dukelec/cdfoc/hardware/cdfoc_pcb_v4.1.png

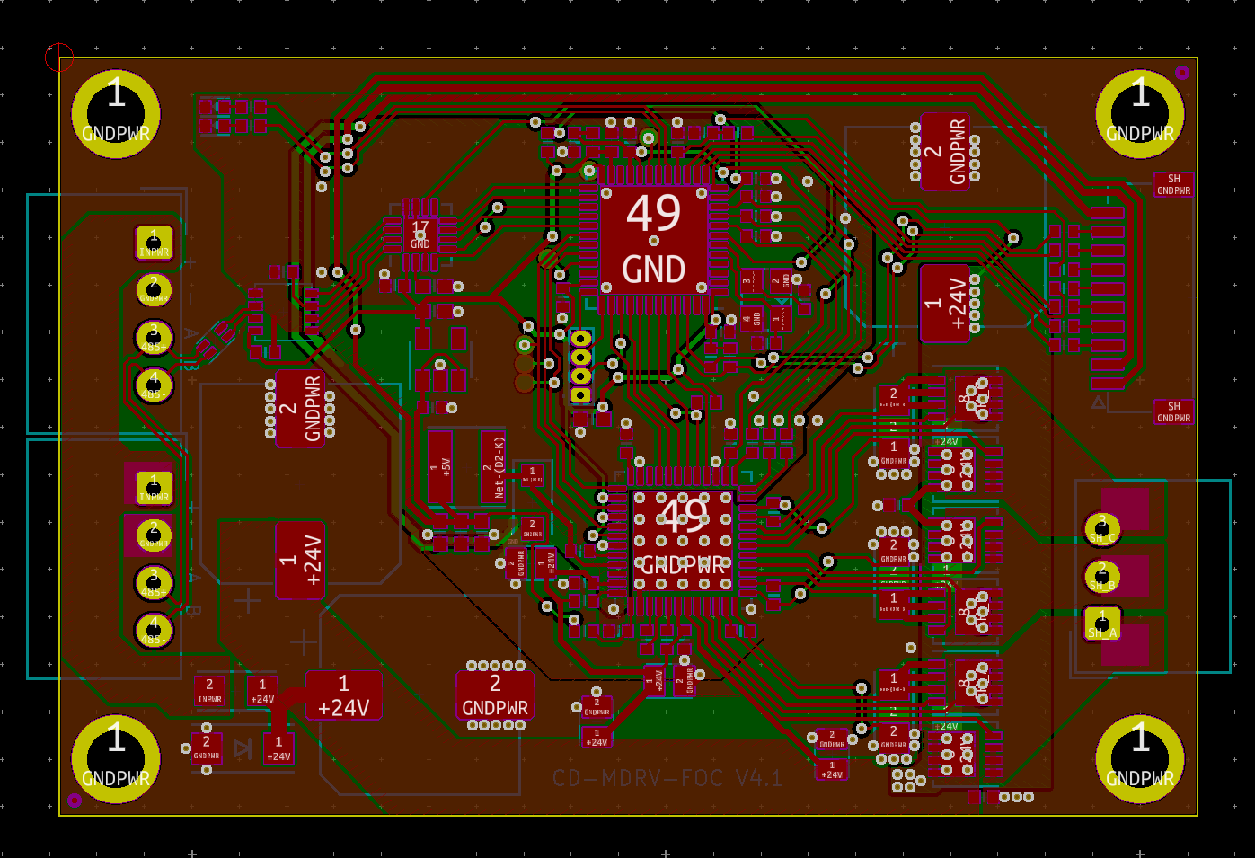
hardware/cdfoc_pcb_v4.1.png
