dukelec/cdfoc/hardware/sensor_tle5014_v1.png

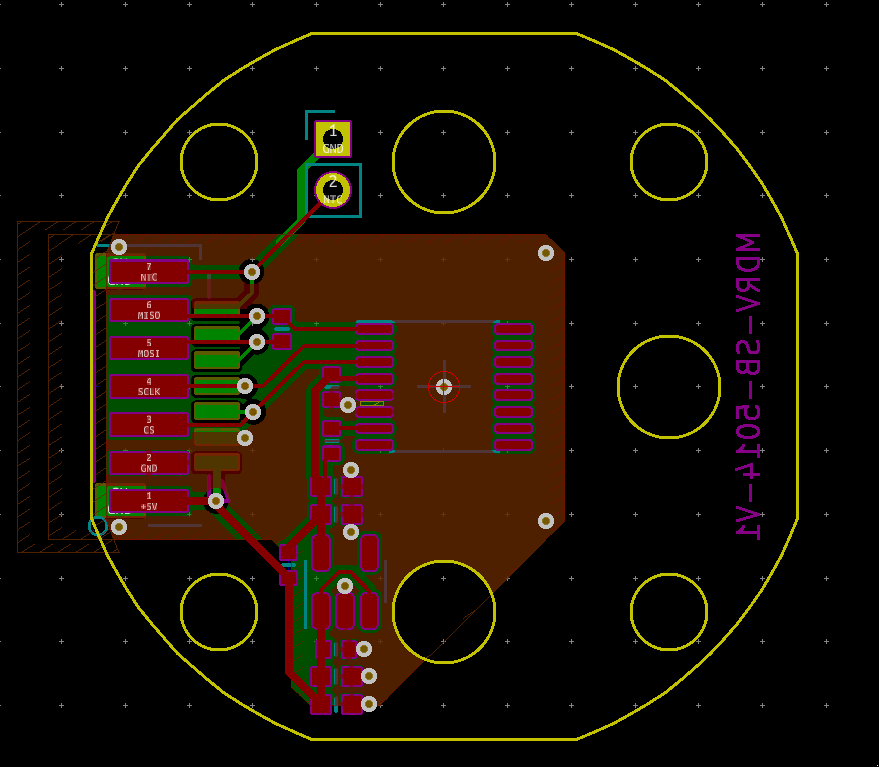
hardware/sensor_tle5014_v1.png
