dukelec/cdfoc/hardware/cdfoc_driver_v4.4_todo.pdf

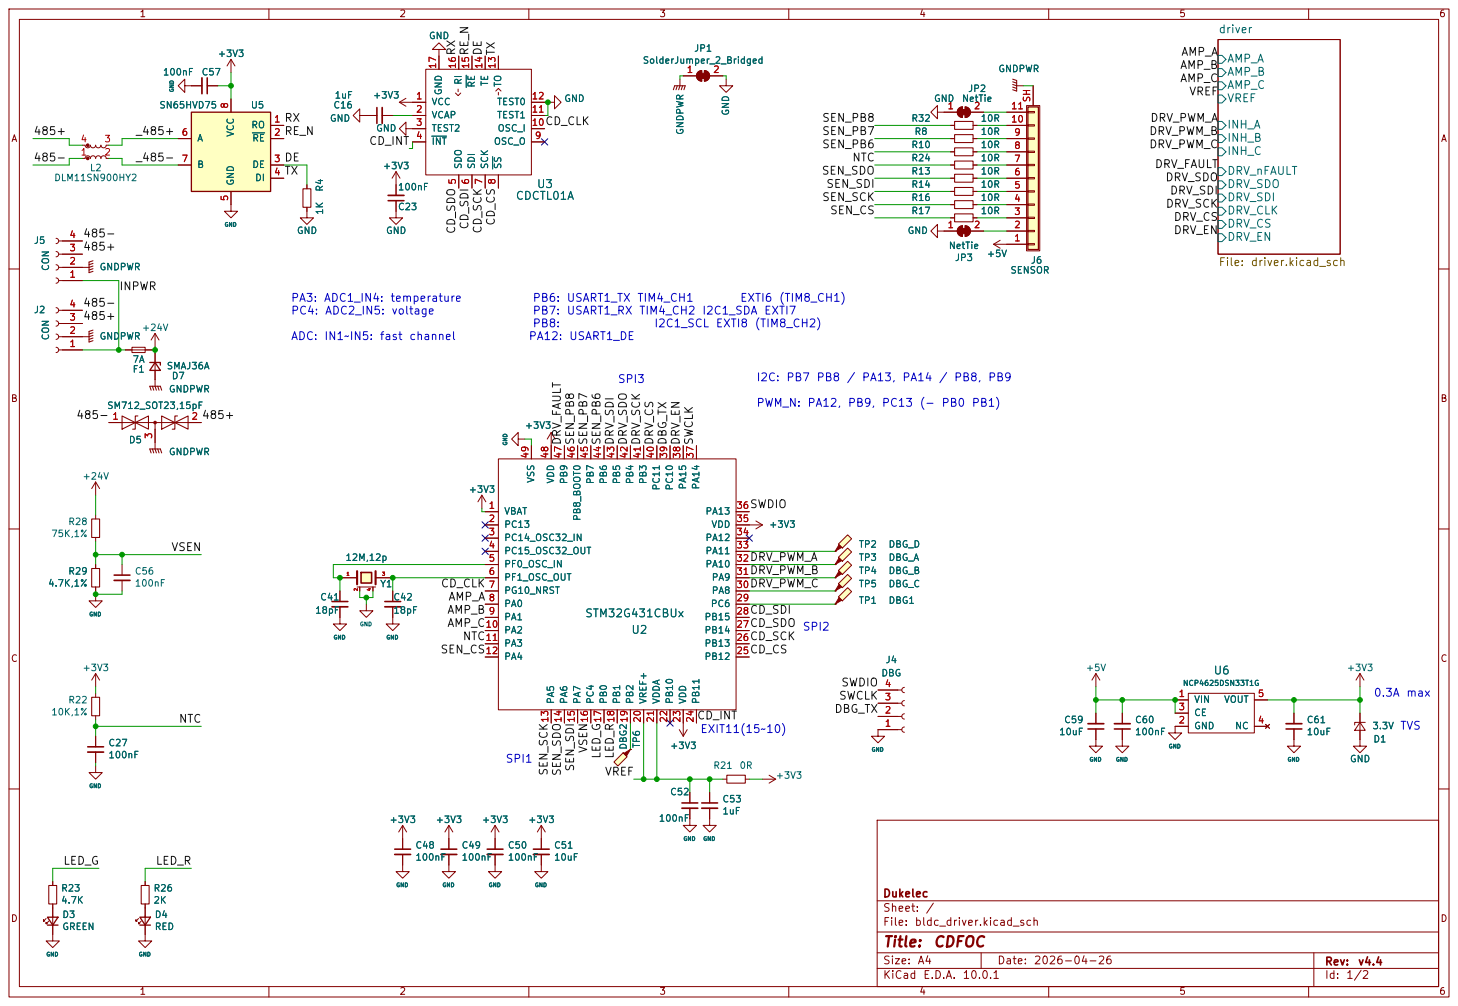
[picture p3: page 1]

8 OSC_O 9 OSC_I 10 TEST1 11 TEST0 12 TO 13 TE 14 RE 15 RI 16 GND 17 GND

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

Size: A4 | Rev: v4.4
KiCad E.D.A. 10.0.1 | Id: 1/2

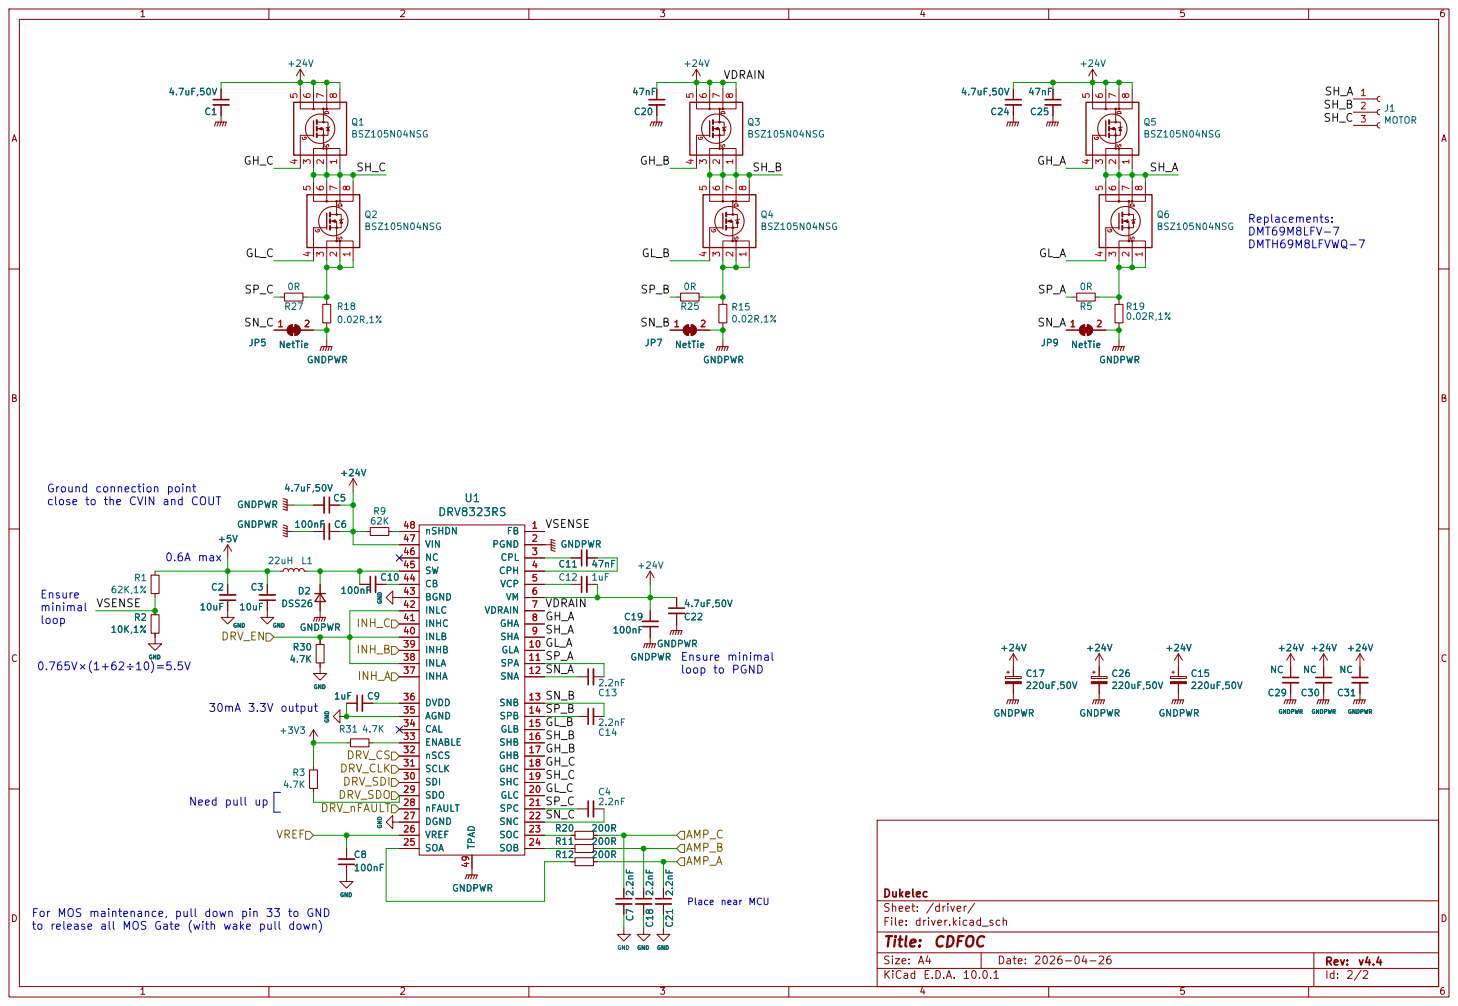
[picture p4: page 2]

Ground connection point
close to the CVIN and COUT

For MOS maintenance, pull down pin 33 to GND
to release all MOS Gate (with wake pull down)

Size: A4 | Rev: v4.4
KiCad E.D.A. 10.0.1 | Id: 2/2
