dukelec/cdfoc/hardware/sensor_tle5012_v1.pdf

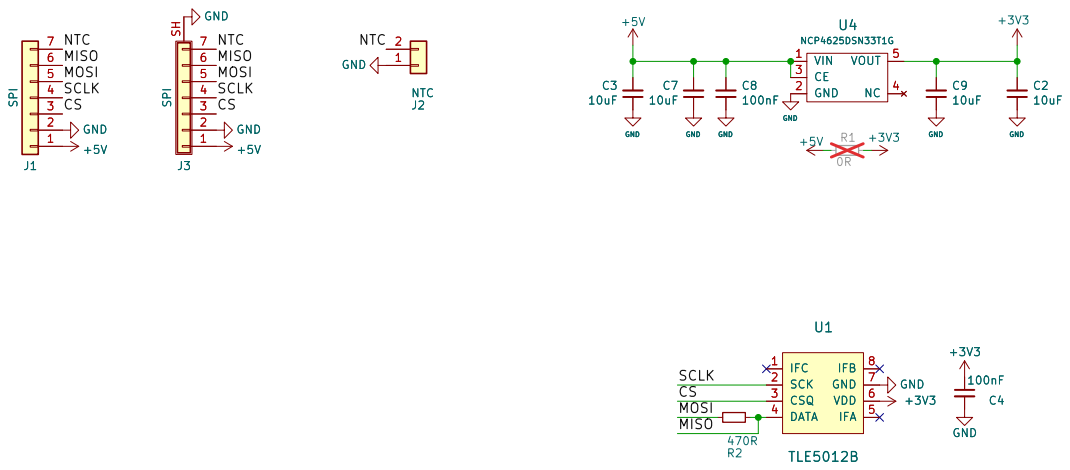
[picture p5: page 1]

Size: A4 | Rev: V1
KiCad E.D.A. 10.0.1 | Id: 1/1
