dukelec/cdfoc/hardware/cdfoc_driver_v4.3.1.pdf

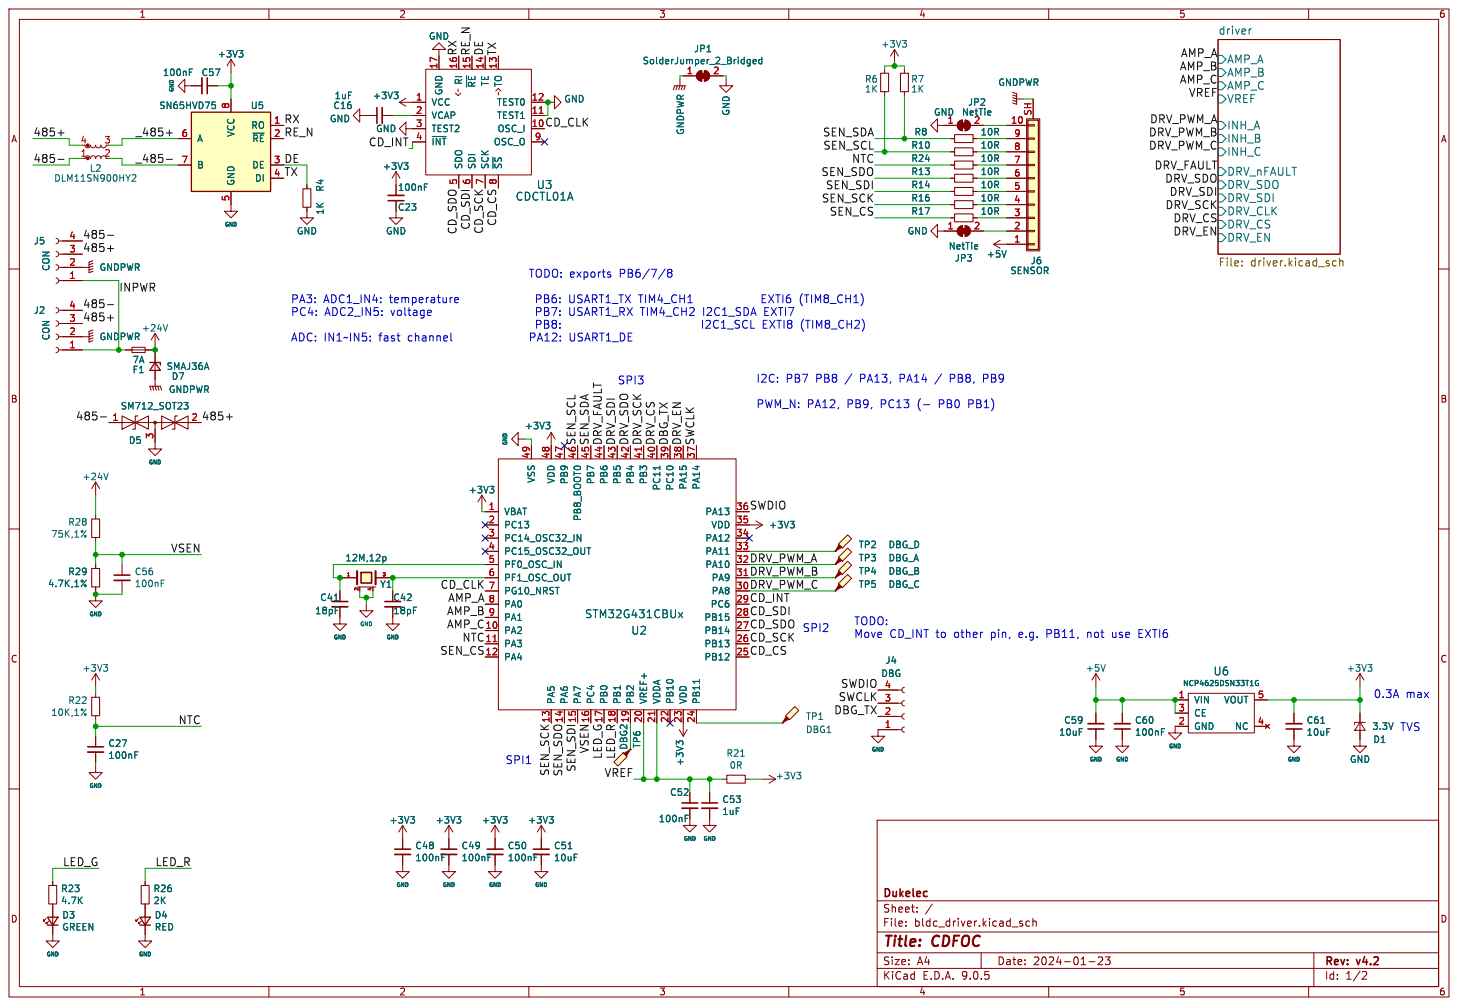
[picture p6: page 1]

driver File: driver.kicad_sch D3 GREEN

5 ~{RE}15 SDI 6 TE 14 SCK

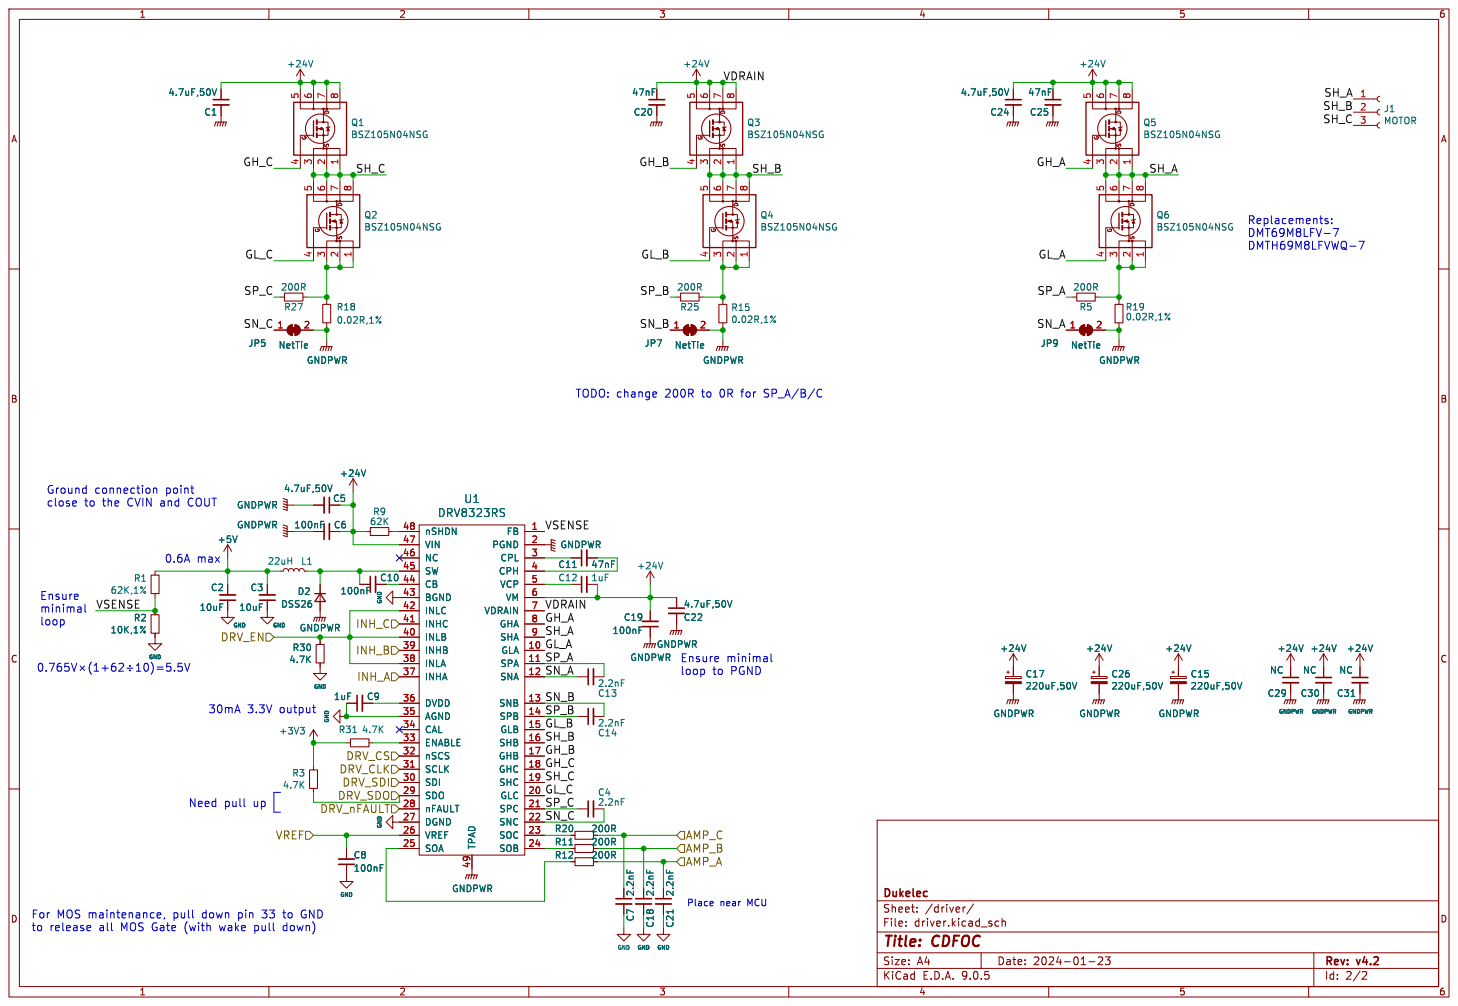
[picture p7: page 2]

TODO: change 200R to 0R for SP_A/B/C
100nF GND GND C8
D2 DSS26 R30

Place near MCU Ensure minimal

to release all MOS Gate (with wake pull down) Need pull up

File: driver.kicad_sch Sheet: /driver/ Dukelec
