dukelec/cdfoc/hardware/sensor_tle5014_v1.pdf

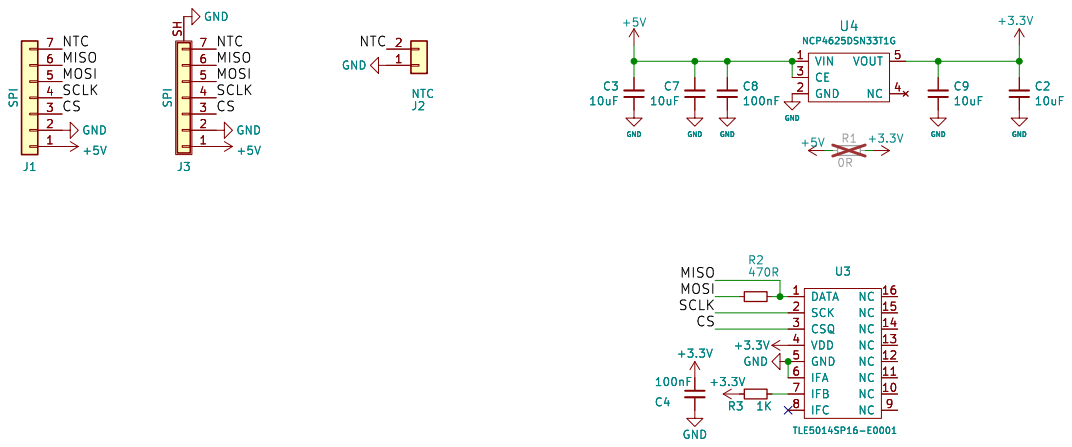
[picture p8: page 1]

Id: 1/1 Title: CDFOC SENSOR TLE5014
