dukelec/cdfoc/hardware/cdfoc_driver_v4.2.pdf

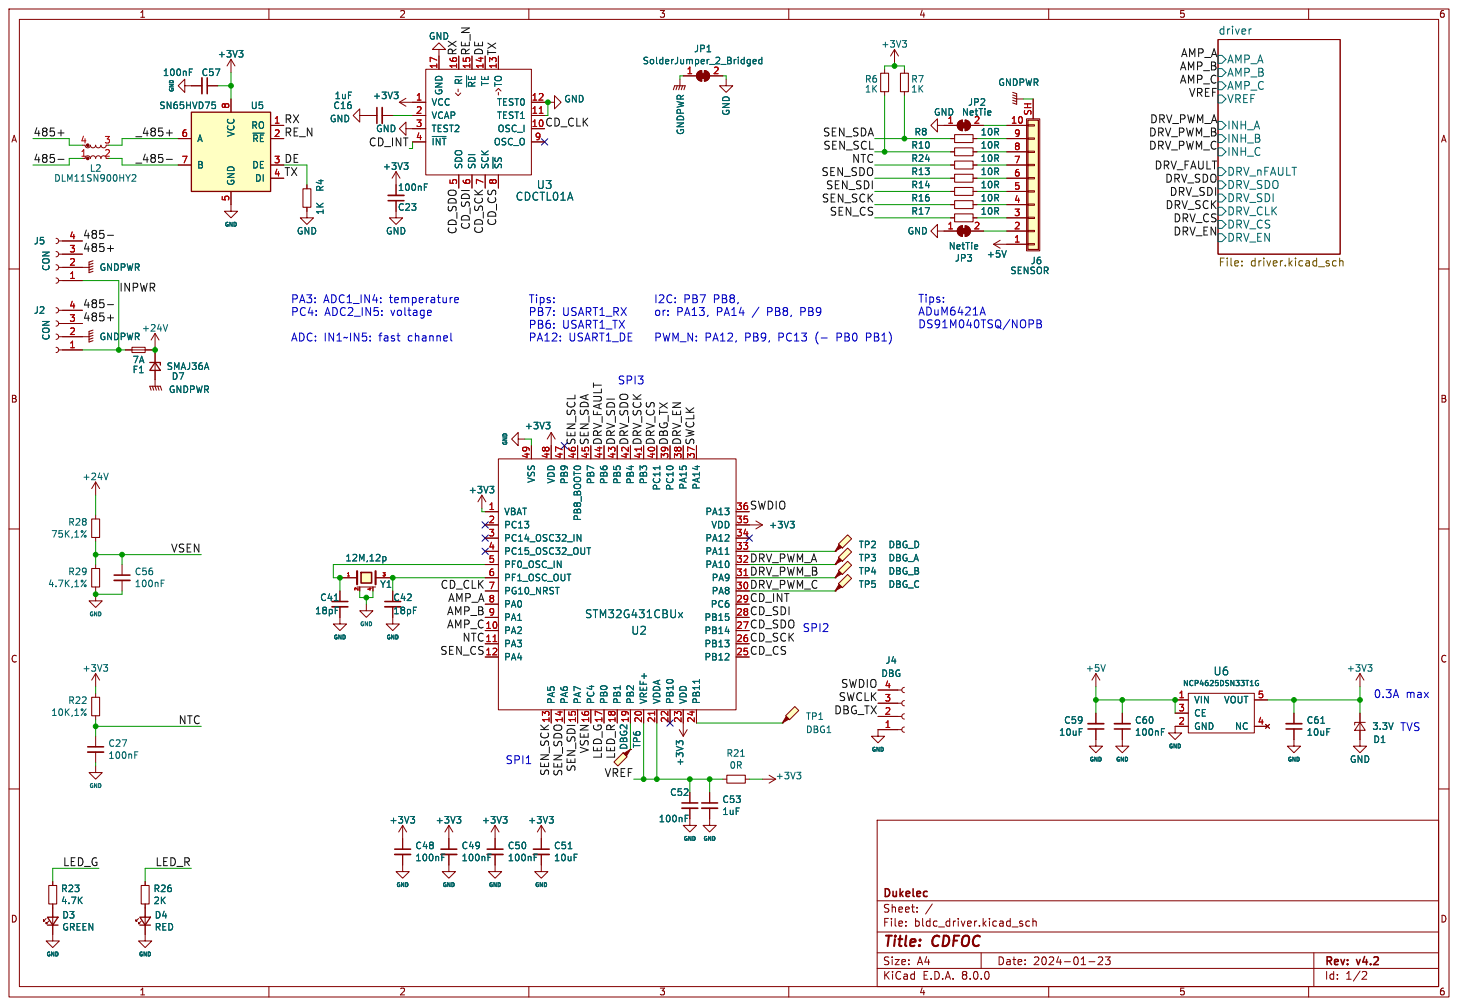
[picture p9: page 1]

7 ~{SS} 8 OSC_O 9 GND GND GND

RO 1 ~{RE}2 DE 3 DI 4 GND

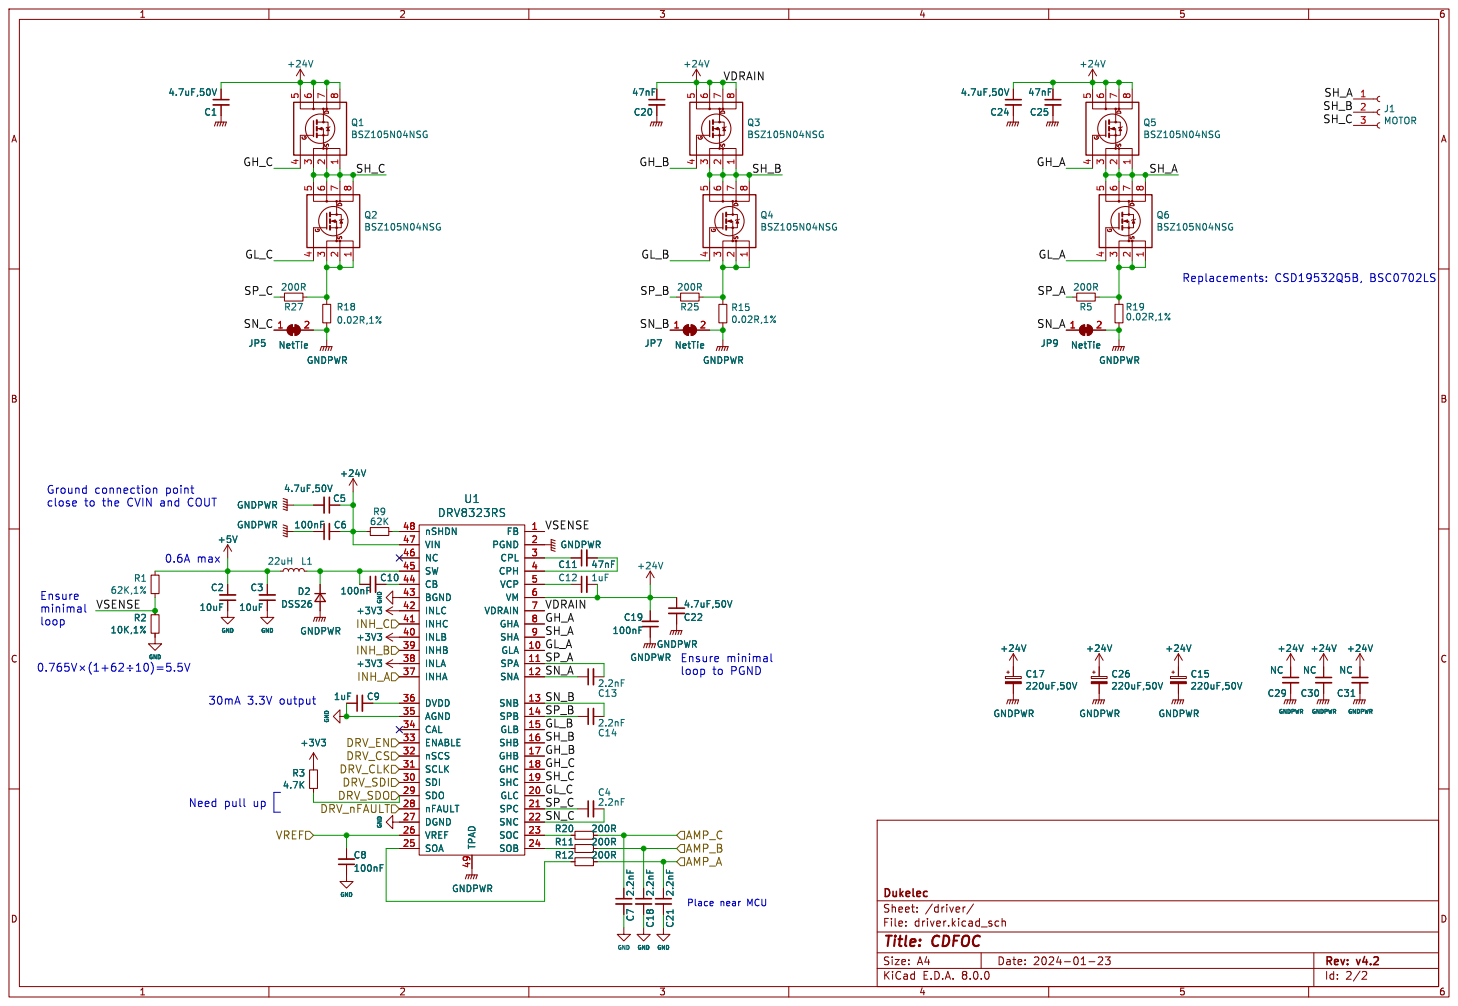
[picture p10: page 2]

File: driver.kicad_sch Sheet: /driver/ Dukelec
