dukelec/cdfoc/hardware/cdfoc_driver_v4.1.pdf

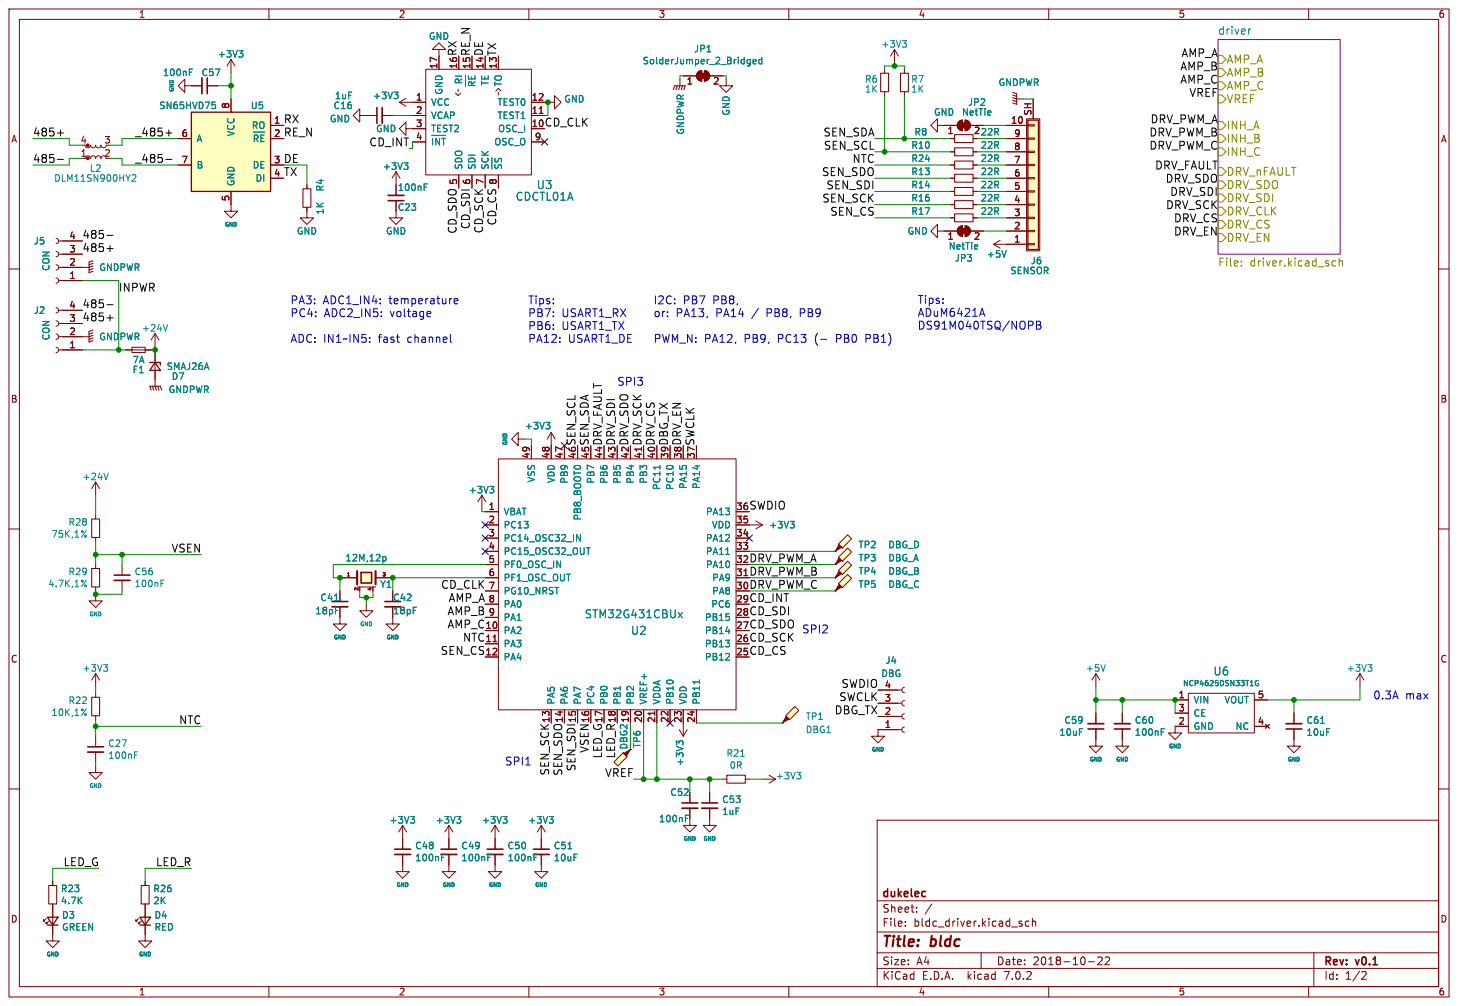
[picture p11: page 1]

7 ~{SS} 8 OSC_O 9 GND GND GND R4 1KC23

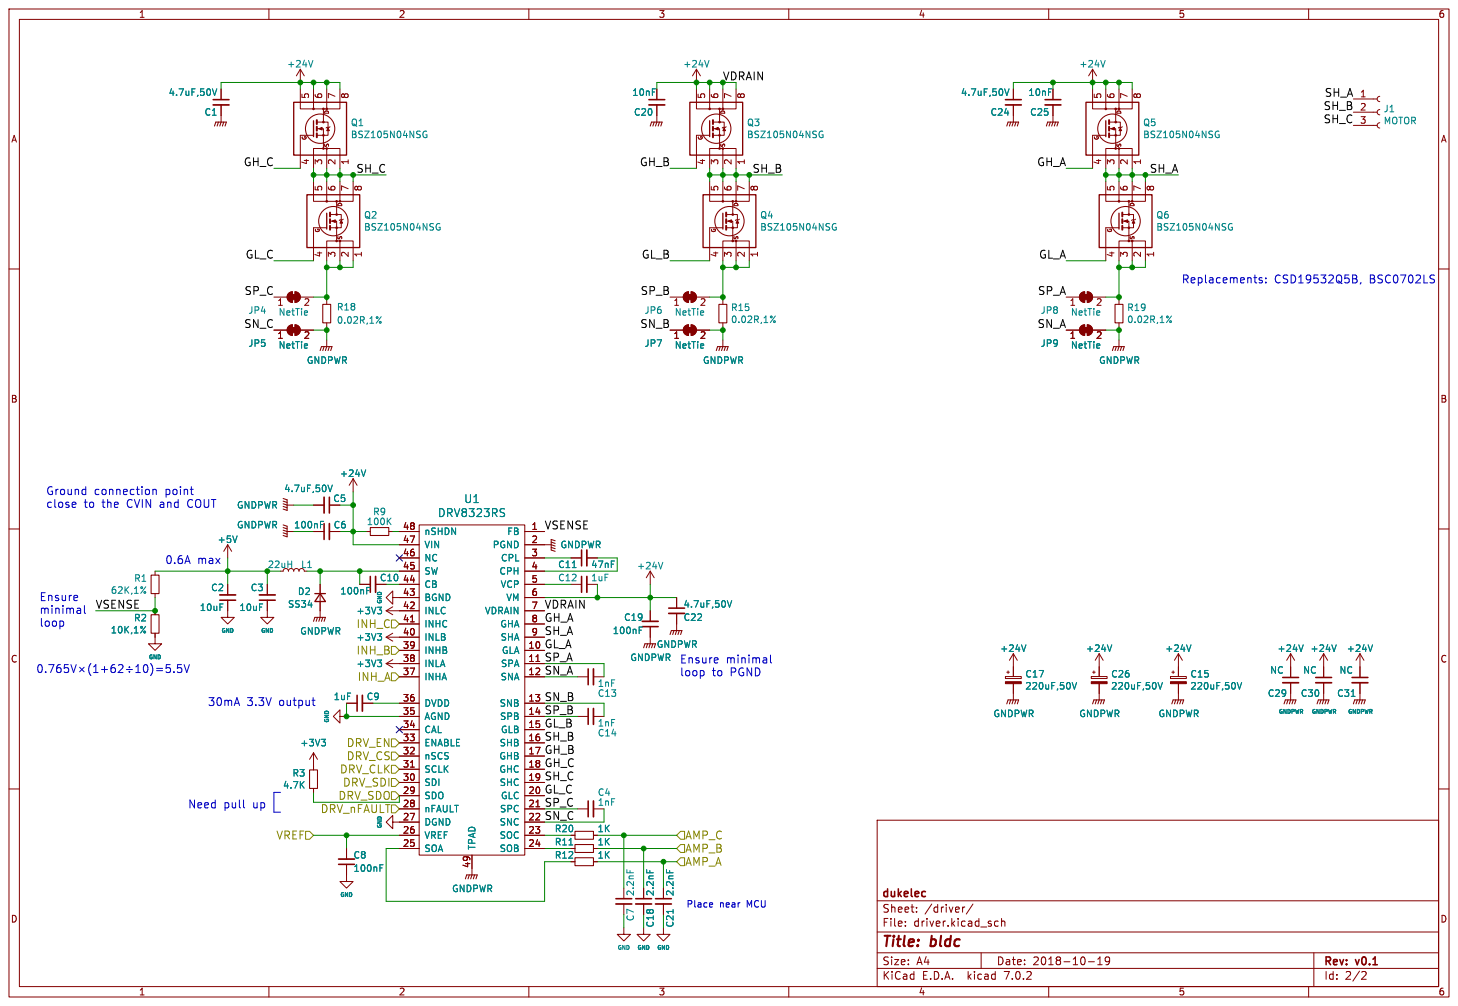
[picture p12: page 2]

+3V3 GNDPWR
GND GNDPWR
FB 1 GLA 10 SPA 11 SNA 12 SNB 13 SPB 14 GLB 15 SHB 16 GHB 17 GHC 18 SHC 19 PGND 2 GLC 20 SPC 21 SNC 22 SOC 23 SOB 24 SOA 25 VREF 26 DGND 27
INLC 42 BGND 43 CB 44 SW 45 NC 46 VIN 47

+3V3 +3V3 GND C10

nSCS 32 ENABLE 33 CAL 34 AGND 35 DVDD 36

File: driver.kicad_sch Sheet: /driver/ dukelec
