dukelec/cdfoc/mdrv_fw/mdrv_fw.ioc

Mcu.UserName=STM32G431CBUx
PA0.Signal=SharedAnalog_PA0
PA1.Signal=SharedAnalog_PA1
PA10.Signal=S_TIM1_CH3
PA11.Signal=S_TIM1_CH4
PA13.Signal=SYS_JTMS-SWDIO
PA14.Signal=SYS_JTCK-SWCLK
PA15.GPIO_Label=DRV_EN
PA15.Signal=GPIO_Output
PA2.Signal=ADC1_IN3
PA3.Signal=ADC1_IN4
PA4.GPIO_Label=SEN_CS
PA4.Signal=GPIO_Output
PA5.Signal=SPI1_SCK
PA6.Signal=SPI1_MISO
PA7.Signal=SPI1_MOSI
PA8.Signal=S_TIM1_CH1
PA9.Signal=S_TIM1_CH2
PB0.GPIO_Label=LED_G
PB0.Signal=GPIO_Output
PB1.GPIO_Label=LED_R
PB1.Signal=GPIO_Output
PB11.GPIO_Label=DBG_OUT1
PB11.Signal=GPIO_Output
PB12.GPIO_Label=CD_CS
PB12.Signal=GPIO_Output
PB13.Signal=SPI2_SCK
PB14.Signal=SPI2_MISO
PB15.Signal=SPI2_MOSI
PB2.GPIO_Label=DBG_OUT2
PB2.Signal=GPIO_Output
PB3.Signal=SPI3_SCK
PB4.Signal=SPI3_MISO
PB5.Signal=SPI3_MOSI
PB6.GPIO_Label=DRV_FAULT
PB6.Signal=GPIO_Input
PB7.Signal=I2C1_SDA
PB8-BOOT0.Signal=I2C1_SCL
PC10.Signal=USART3_TX
PC11.GPIO_Label=DRV_CS
PC11.Signal=GPIO_Output
PC4.Signal=ADC2_IN5
PC6.GPIO_Label=CD_INT
PC6.Signal=GPXTI6
PF0-OSC_IN.Signal=RCC_OSC_IN
PF1-OSC_OUT.Signal=RCC_OSC_OUT
PG10-NRST.Signal=RCC_MCO
