dukelec/cdfoc/mdrv_fw/Core/Inc/main.h

#define SEN_CS_Pin GPIO_PIN_4
#define SEN_CS_GPIO_Port GPIOA
#define LED_G_Pin GPIO_PIN_0
#define LED_G_GPIO_Port GPIOB
#define LED_R_Pin GPIO_PIN_1
#define LED_R_GPIO_Port GPIOB
#define DBG_OUT2_Pin GPIO_PIN_2
#define DBG_OUT2_GPIO_Port GPIOB
#define DBG_OUT1_Pin GPIO_PIN_11
#define DBG_OUT1_GPIO_Port GPIOB
#define CD_CS_Pin GPIO_PIN_12
#define CD_CS_GPIO_Port GPIOB
#define CD_INT_Pin GPIO_PIN_6
#define CD_INT_GPIO_Port GPIOC
#define DRV_EN_Pin GPIO_PIN_15
#define DRV_EN_GPIO_Port GPIOA
#define DRV_CS_Pin GPIO_PIN_11
#define DRV_CS_GPIO_Port GPIOC
#define DRV_FAULT_Pin GPIO_PIN_6
#define DRV_FAULT_GPIO_Port GPIOB
