dukelec/cdfoc/mdrv_fw/usr/csa_sync.h

/*
 * Software License Agreement (MIT License)
 *
 * Copyright (c) 2017, DUKELEC, Inc.
 * All rights reserved.
 *
 * Author: Duke Fong <d@d-l.io>
 */

#ifndef __CSA_SYNC_H__
#define __CSA_SYNC_H__


// adc_samp

static inline void adc_samp2csa(adc_samp_t *as)
{
    memcpy(csa.meas_i, as->meas_i, sizeof(csa.meas_i));
}


// encoder_filter

static inline void csa2encoder_filter_mt(encoder_filter_t *ef)
{
    ef->bias_encoder = csa.bias_encoder;
    ef->bias_pos = csa.bias_pos;
}

static inline void encoder_filter2csa(encoder_filter_t *ef)
{
    csa.nob_encoder = ef->nob_encoder;
    csa.nob_pos = ef->nob_pos;
    csa.meas_encoder = ef->meas_encoder;
    csa.meas_speed = lroundf(ef->meas_speed);
    csa.meas_pos = ef->meas_pos;
    csa.meas_speed_avg = lroundf(ef->meas_speed_avg);
    csa.meas_rpm_avg = ef->meas_rpm_avg;
}


// encoder_linearize

static inline void csa2encoder_linearizer_mt(encoder_linearizer_t *el)
{
    el->max_val = csa.enc_linear_max;
}


// anticog

static inline void csa2anticog_mt(anticog_t *ac)
{
    ac->max_iq = csa.anticog_max_iq;
    ac->ratio_vq = csa.anticog_ratio_vq;
}


// pid

static inline void csa2pid_mt(pid_i_t *pos, pid_f_t *speed, pid_f_t *iq, pid_f_t *id, float v_gain)
{
    pos->kp = csa.pid_pos_kp;
    pos->out_min = csa.pid_pos_out_min;
    pos->out_max = csa.pid_pos_out_max;
    speed->kp = csa.pid_speed_kp;
    speed->ki = csa.pid_speed_ki;
    speed->out_min = csa.pid_speed_out_min;
    speed->out_max = csa.pid_speed_out_max;
    iq->kp = csa.pid_iq_kp * v_gain;
    iq->ki = csa.pid_iq_ki * v_gain;
    iq->out_min = csa.pid_iq_out_min;
    iq->out_max = csa.pid_iq_out_max;
    id->kp = csa.pid_id_kp * v_gain;
    id->ki = csa.pid_id_ki * v_gain;
    id->out_min = csa.pid_id_out_min;
    id->out_max = csa.pid_id_out_max;
}


// trap_planner

static inline void csa2trap_planner_mt(trap_planner_t *tp)
{
    tp->max_err = csa.tp_max_err;
}

static inline void csa2trap_planner(trap_planner_t *tp)
{
    tp->pos_tgt = csa.tp_pos;
    tp->vel_tgt = csa.tp_speed;
    tp->acc_tgt = csa.tp_accel;
}

static inline void trap_planner2csa_rst(trap_planner_t *tp)
{
    csa.tp_pos = tp->pos_tgt;

    csa.tp_state = tp->state;
    csa.tp_vel_out = lroundf(tp->vel_out);
}

static inline void trap_planner2csa(trap_planner_t *tp)
{
    csa.tgt_pos = tp->pos_out;

    csa.tp_state = tp->state;
    csa.tp_vel_out = lroundf(tp->vel_out);
}

#endif
