dukelec/cdfoc/(commit log)

2018-12-11 adc and pwm work together ok
2018-12-23 stm32cube: forgot to enable cdctl interrupt
2018-12-26 cal current
2020-09-24 update by stm32cube
2020-10-17 backup encoder filter
2020-10-18 update encoder filter
2020-10-20 pid now better
2020-12-15 stm32cube for stm32g431cbux
2020-12-22 simplify encoder filter
2020-12-27 add encoder_reg_r/w for 5012b
2020-12-29 reduce mosfet gate-current
2020-12-29 t_curve: avoid exceeding; fix change direction issue
    [app_motor.c, config.c]
2020-12-30 add i_sd pid
2020-12-30 use moving average filter for adc
2021-02-23 two direction calibration
2021-02-24 add reg r/w for sensor ma73x
2021-03-02 clip pos pid item
2021-03-03 modify pid without reboot
    [app_motor.c]
2021-03-04 fix average calculation of cali
    [app_main.c]
2021-07-02 timer dma set gpio test ok
2021-07-02 sensor spi dma sync by timer dma
2021-07-02 adc read temperature and dc ok
2021-07-03 avoid regular adc side effect
    [app_main.c, app_motor.c]
2021-07-25 increase adc sampling time
2021-07-25 compensation sensor latency
2021-07-31 select multiple adc for one pin
2021-08-21 check drv_fault pin
2021-10-02 add temperature sensor; fix stop during fault increase main voltage
    [app_main.c, app_motor.c]
2021-10-02 not increase main voltage by disable the enable pin
2021-10-13 add rpm and vibration to csa
    [app_main.c, app_main.h, app_motor.c, config.c]
2021-10-28 add dbg ia ib ic; limit pwm range
2021-11-27 add pwm_over_limit test
2021-11-27 calculate adc offset before run
2021-12-08 limit sq sd magnitude; auto switch adc channel
2021-12-09 change target current smoothly
2021-12-25 shutdown all half-bridges when error
    [app_main.c, app_motor.c, config.c]
2021-12-26 increase current change speed
2021-12-30 set all current adc channels to 6.5 cycles times
2022-01-01 reduce max pwm
2022-03-30 start encoder read in pwm ch4 isr
2022-03-30 remove rpm and vibration from csa
    [app_main.c, app_main.h, app_motor.c, config.c]
2022-03-31 fix sensor ma73x
2022-09-26 reset hist for pid
    [pid_i.c]
2022-09-27 fix issue when tc_speed set lower during running
    [app_motor.c]
2023-08-29 stm32cube update
2023-08-30 add schematic
2023-08-30 position pid output current instead of speed
2023-09-21 enable kp for speed pid
2023-09-21 revert: position pid output current instead of speed
    [app_motor.c, config.c]
2023-11-19 fix accel caculation in speed mode
    [app_motor.c]
2024-04-11 update by stm32cube 1/2
2024-04-11 update by stm32cube 2/2
2024-04-18 deliver 15% more power by svpwm
2024-07-01 fix encoder dat late warning, last cube updates has faster adc interrupt
    [app_main.c]
2024-07-15 rename current pid output identifier from 'i' to 'v'
2024-07-29 check all led during power on
2024-08-06 add next version hardware schematic:
    use INLx instead of driver_en
2024-09-06 show ntc temperature
2024-10-24 update cdnet; update bias_encoder when finish calibration
2024-11-29 update by stm32cube; change size type of regr_t
2025-02-18 supports software reboot selection
    [app_main.c, app_main.h, app_motor.c, common_services.c, config.c]
2025-03-30 fix abs has no effect warning
    [app_main.h, app_motor.c]
2025-03-30 allow swap motor wiring by software
    [app_main.h, app_motor.c, config.c]
2025-04-08 add workaround for nrst as gpio failure
    [app_main.c, common_services.c]
2025-05-01 simplify encoder multi-turn handling
2025-07-10 add filter for encoder position
2025-07-10 pid setpoint ramping
2025-07-15 update pid
2025-07-16 not use d term for pid; update default config
2025-08-03 adjust adc sampling position to compensate current delay
2025-08-05 using i_sd for encoder cali
2025-08-15 remove print debug in current loop
2025-08-17 allow realtime mode switch
2025-08-18 using i_sq for encoder cali, auto set motor_poles/wire_swap
2025-09-08 fix auto set motor_polse
    [app_main.h]
2025-10-28 add pwm dead-time compensation
2025-11-06 change plot x-axis cnt from 4 bytes to 2 bytes
2025-11-11 fix qxchg partial write issue
    [common_services.c]
2026-08-11 compensate current-loop pid gains and anticog vq for bus voltage variation
